Mmrliu-gooooood/digital_pen/实施方案.md

# ESP32-S3 + OV5640 黑白 Anoto 点阵笔实施方案

> **For agentic workers:** REQUIRED SUB-SKILL: Use `superpowers:subagent-driven-development` (recommended) or `superpowers:executing-plans` to implement this plan task-by-task. Steps use checkbox (`- [ ]`) syntax for tracking.

**Goal:** 使用 ESP32-S3 N16R8 和 OV5640 采集白底黑点 Anoto 纸面图像，先在 PC 端通过 Python/OpenCV 恢复 Anoto 坐标、笔尖轨迹和简单字符结果，算法稳定后再逐步移植到 ESP32-S3。

**Architecture:** Task 4～10 属于开发与算法验证阶段：ESP32-S3 采集无损灰度帧，通过 Wi-Fi STA + HTTP 交给同一局域网内的 PC；STA 连接失败时自动回退 SoftAP，USB 作为实验室诊断和可选原始帧通道。PC 完成视觉、Anoto 解码、轨迹与识别。Task 11 开始进入笔形产品架构：视觉坐标前端移植到 ESP32-S3，终端不再接收原始帧，而通过 BLE 自定义 GATT 接收坐标和笔状态。

**Tech Stack:** ESP-IDF、`espressif/esp32-camera ^2.1.7`、ESP32-S3 N16R8、OV5640、C/C++、Python 3.11+、OpenCV、NumPy、pytest、py-microdots、Rust AnotoPdfGenerator/AnotoDotReader（外部参考工具）。

**Spec:** `D:\ESP32_project\digital_pen\实施方案.md`（本文第 1～7 节同时作为已确认的设计规格）。

## Global Constraints

- 最终纸张必须是白底黑点，不依赖彩色打印或颜色分类。
- 原型采用“PC 先验证算法，再移植 ESP32-S3”；手写识别初期保留在 PC。
- Task 4～10 仅使用 Wi-Fi/USB 传输原始灰度帧；Task 11 起使用 BLE 传输坐标。BLE 不承担原始 QVGA 帧传输。
- Anoto 图案由 `D:\ESP32_project\AnotoPdfGenerator\AnotoPdfGenerator-main` 生成，解码协议与该项目及 py-microdots 保持一致。
- `D:\ESP32_project\AnotoDotReader\AnotoDotReader-main` 只作为网格处理和解码参考；其当前颜色方向分类不能直接用于黑白点阵。
- 每张点阵纸必须保留 PDF、方向矩阵、section、网格间距、点半径和方向偏移量，保证算法结果可与生成真值比较。
- `app_main` 只做初始化和任务编排，不承载图像算法。
- PC 端视觉模块只输出方向矩阵；Anoto 模块只处理方向矩阵和坐标协议，不依赖 OpenCV。
- 第一版落笔判断允许通过新墨迹延迟确认；压力传感器、微动开关等外设不进入第一版范围。
- 新墨迹确认采用 100～200 ms 坐标环形缓冲，确认后回溯形成笔画起点。
- 当前 `sdkconfig` 未开启 PSRAM，进入连续采集前必须为 N16R8 开启并验证 8 MB PSRAM。
- 当前开发板未给出确切相机 GPIO 映射；实现时必须从实际原理图和接线记录生成板级引脚文件，不得套用其他 ESP32-S3 Camera 板的默认引脚。
- 不直接复制 AnotoPdfGenerator、AnotoDotReader 或 py-microdots 源码到本工程；通过适配器或包依赖连接，避免维护分叉版本。

---

## 1. 当前状态与范围

### 1.1 当前工程状态

工程位置：`D:\ESP32_project\digital_pen\digital_pen_ov5640`

- `main/main.c` 只有空的 `app_main()`。
- `main/idf_component.yml` 已声明 `espressif/esp32-camera: ^2.1.7`。
- `sdkconfig` 已启用 OV5640 支持。
- `sdkconfig` 尚未启用 PSRAM。
- 尚无相机 GPIO、像素格式、分辨率、采集、传输或 PC 客户端实现。

### 1.2 第一版完成定义

第一版完整闭环定义为：

```text
黑白 Anoto 纸
  → OV5640 灰度帧
  → PC 黑点/网格/方向识别
  → Anoto 坐标
  → 笔尖纸面坐标
  → 新墨迹确认落笔
  → 笔画序列
  → 小规模字符集识别结果
```

第一版不要求：

- 全部常用汉字的高准确率识别；
- 自然书写速度下的商业级跟踪；
- 所有视觉算法和识别模型都运行在 ESP32-S3；
- 在已有墨迹上重复书写时仍能只凭图像准确判断落笔；
- 更换任意镜头、纸张或打印机后无需重新标定。

---

## 2. 总体架构与数据接口

```text
AnotoPdfGenerator
  ├─ 黑白点阵 PDF
  ├─ 方向矩阵 JSON
  └─ 图案参数清单
          ↓
ESP32-S3 + OV5640
  ├─ Task 4～10：灰度帧、帧号、时间戳、曝光信息
  │       └─ Wi-Fi STA + HTTP（主通道，失败回退 SoftAP）/ USB（诊断、可选）→ PC
  └─ Task 11 起：板端视觉与 Anoto 坐标解码
          └─ BLE 自定义 GATT → 坐标、置信度、落笔状态 → 终端
          ↓（开发阶段 PC 视觉流水线）
Python/OpenCV
  ├─ 镜头校正
  ├─ 黑点质心
  ├─ 网格与透视
  └─ 上下左右方向矩阵
          ↓
Anoto Codec
  ├─ 多个 6×6 窗口解码
  └─ 一致性投票与置信度
          ↓
笔尖坐标
  ├─ 相机像素到纸面坐标
  └─ 轨迹滤波
          ↓
墨迹与笔画
  ├─ 已知点阵背景扣除
  ├─ 新墨迹延迟确认
  └─ 落笔/抬笔分段
          ↓
PC 手写识别
```

### 2.1 PC 端核心类型

在 `pc/src/digital_pen/types.py` 中统一定义以下类型，后续模块不得自行创建同义结构：

```python
from dataclasses import dataclass
from enum import IntEnum
import numpy as np

class DotDirection(IntEnum):
    UP = 0
    LEFT = 1
    RIGHT = 2
    DOWN = 3

@dataclass(frozen=True)
class CameraFrame:
    frame_id: int
    timestamp_us: int
    image: np.ndarray          # uint8, shape=(height, width)
    exposure: int | None

@dataclass(frozen=True)
class DotObservation:
    center_px: tuple[float, float]
    area_px: float
    circularity: float

@dataclass(frozen=True)
class LatticeModel:
    grid_to_image: np.ndarray  # float64, shape=(3, 3)
    spacing_px: float
    rms_error_px: float

@dataclass(frozen=True)
class DirectionObservation:
    row: int
    col: int
    direction: DotDirection
    residual_grid: tuple[float, float]
    confidence: float

@dataclass(frozen=True)
class DecodedPose:
    timestamp_us: int
    page_id: str
    x_grid: float
    y_grid: float
    rotation_quadrants: int
    confidence: float

@dataclass(frozen=True)
class PenPoint:
    timestamp_us: int
    x_mm: float
    y_mm: float
    confidence: float
    pen_down: bool
```

### 2.2 Task 4～10：开发阶段原始帧接口

开发固件默认以 STA 模式连接已配置的 2.4 GHz Wi-Fi，PC 保持连接同一局域网，并使用串口日志输出的 DHCP 地址访问设备。15 秒内未取得 IP 时，设备自动启动 SoftAP，回退地址为 `http://192.168.4.1`。原型统一使用两个 HTTP 端点：

- `GET /status`：返回 JSON，至少包含传感器型号、分辨率、像素格式、PSRAM 大小和帧计数。
- `GET /capture.pgm`：返回一帧二进制 PGM（P5）灰度图，并用 HTTP Header 返回 `X-Frame-Id`、`X-Timestamp-Us`、`X-Exposure`。

PGM 可避免 JPEG 压缩破坏微小黑点质心。USB 保留为实验室诊断和后续可选原始帧通道，不作为 Task 4 的 Exit Gate；连续实时性能不足时，再在 Wi-Fi 或 USB 上增加长连接二进制流。

### 2.3 Task 11 起：最终产品 BLE 坐标接口

ESP32-S3 作为 BLE Peripheral 暴露自定义 Digital Pen Service，终端订阅坐标通知。通知负载只携带协议版本、序号、时间、页面/区域标识、`x/y` 坐标、置信度和 `pen_down`，不传原始图像。单包优先控制在协商后的 ATT MTU 内；断线后继续递增序号，终端据此检测丢包。调试固件可以保留按需抓取原始帧的 Wi-Fi/USB 能力，但默认关闭，不属于产品实时数据通道。

---

## 3. 建议源码目录

```text
digital_pen_ov5640/
├── CMakeLists.txt
├── sdkconfig
├── sdkconfig.defaults
├── main/
│   ├── CMakeLists.txt
│   ├── app_main.c
│   └── app_config.h
├── components/
│   ├── camera_capture/
│   │   ├── CMakeLists.txt
│   │   ├── include/camera_capture.h
│   │   ├── camera_capture.c
│   │   └── board_camera_pins.h
│   ├── frame_transport/
│   │   ├── CMakeLists.txt
│   │   ├── include/frame_transport.h
│   │   ├── frame_transport.c
│   │   └── transport_http.c
│   ├── network_manager/
│   │   ├── CMakeLists.txt
│   │   ├── include/network_manager.h
│   │   └── network_manager.c
│   ├── device_protocol/
│   │   ├── CMakeLists.txt
│   │   ├── include/device_protocol.h
│   │   └── device_protocol.c
│   ├── anoto_embedded/
│   │   ├── CMakeLists.txt
│   │   ├── include/anoto_embedded.h
│   │   ├── dot_detector.c
│   │   ├── grid_fitter.c
│   │   ├── direction_classifier.c
│   │   └── anoto_decoder.c
│   ├── pen_pose/
│   │   ├── CMakeLists.txt
│   │   ├── include/pen_pose.h
│   │   └── pen_pose.c
│   ├── pen_state/
│   │   ├── CMakeLists.txt
│   │   ├── include/pen_state.h
│   │   └── pen_state.c
│   └── ble_transport/
│       ├── CMakeLists.txt
│       ├── include/ble_transport.h
│       └── ble_transport.c
├── pc/
│   ├── pyproject.toml
│   ├── README.md
│   ├── src/digital_pen/
│   │   ├── __init__.py
│   │   ├── types.py
│   │   ├── camera/
│   │   │   ├── esp32_client.py
│   │   │   └── frame_recorder.py
│   │   ├── calibration/
│   │   │   ├── camera_calibration.py
│   │   │   ├── distortion.py
│   │   │   └── nib_calibration.py
│   │   ├── vision/
│   │   │   ├── preprocessing.py
│   │   │   ├── dot_detector.py
│   │   │   ├── grid_fitter.py
│   │   │   ├── perspective.py
│   │   │   └── direction_classifier.py
│   │   ├── anoto/
│   │   │   ├── matrix_builder.py
│   │   │   ├── codec_adapter.py
│   │   │   └── window_consensus.py
│   │   ├── pose/
│   │   │   ├── page_pose.py
│   │   │   ├── nib_mapper.py
│   │   │   └── position_filter.py
│   │   ├── ink/
│   │   │   ├── dot_background.py
│   │   │   ├── ink_detector.py
│   │   │   └── pen_state_estimator.py
│   │   ├── strokes/
│   │   │   ├── point_buffer.py
│   │   │   ├── stroke_builder.py
│   │   │   └── stroke_normalizer.py
│   │   ├── recognition/
│   │   │   ├── recognizer.py
│   │   │   └── onnx_recognizer.py
│   │   └── pipeline/
│   │       ├── offline_pipeline.py
│   │       └── live_pipeline.py
│   ├── apps/
│   │   ├── capture_frame.py
│   │   ├── calibrate_camera.py
│   │   ├── inspect_dots.py
│   │   ├── decode_image.py
│   │   ├── live_coordinates.py
│   │   └── live_handwriting.py
│   └── configs/
│       ├── camera.yaml
│       ├── dot_detection.yaml
│       ├── pattern.yaml
│       └── nib_calibration.yaml
├── tools/patterns/
│   ├── generate_pattern.py
│   ├── verify_codec.py
│   └── generator_adapter.py
└── docs/
    ├── camera-pinout.md
    ├── pattern-parameters.md
    └── calibration.md
```

`anoto_embedded`、`pen_pose`、`pen_state` 和 `ble_transport` 在对应移植阶段再创建；早期不放无实现的空壳组件。

---

## 4. 点阵与光学分级

所有等级都使用黑色点，不增加彩色打印成本。

| 等级 | 网格间距 | 方向偏移 | 点半径 | 用途 |
|---|---:|---:|---:|---|
| A：算法调试 | 3.53 mm（10 pt） | 1.06 mm（3 pt） | 0.35 mm（1 pt） | 验证协议、网格和方向分类 |
| B：光学过渡 | 1.00 mm | 0.167 mm | 0.10 mm | 验证真实黑点、透视和运动 |
| C：目标微点 | 0.30 mm | 0.05 mm | 0.05 mm | 接近标准 Anoto 尺寸 |

目标微点方向偏移只有约 0.05 mm。为了在图像中形成至少 2 像素偏移，成像比例至少需要约 40 px/mm；VGA 宽度 640 像素时，横向视场应不大于约 16 mm。达到该条件通常需要合适的近摄镜头、稳定工作距离和均匀照明。

每一级只有在静态坐标解码成功率达到本方案门槛后才缩小尺寸。尺寸分级是降低光学风险，不改变 Anoto 编码协议。

---

## 5. 分阶段实施任务

### Task 1：建立黑白点阵生成与协议真值

**Files:**

- Create: `tools/patterns/generator_adapter.py`
- Create: `tools/patterns/verify_codec.py`
- Create: `pc/configs/pattern.yaml`
- Create: `docs/pattern-parameters.md`

**Interfaces:**

- Consumes: AnotoPdfGenerator 输出的 PDF 和方向矩阵 JSON。
- Produces: `PatternManifest`，字段固定为 `page_id`、`section_u`、`section_v`、`rows`、`cols`、`grid_spacing_mm`、`dot_radius_mm`、`offset_mm`、`matrix_json`、`pdf_path`。

- [ ] **Step 1: 固化三级黑白点阵参数**

在 `pc/configs/pattern.yaml` 中写入 A/B/C 三个 profile，所有方向颜色统一为 `#000000`，尺寸使用第 4 节数值。

- [ ] **Step 2: 编写生成器适配器**

`generator_adapter.py` 负责读取 profile、调用外部 Generator，并为 PDF 和矩阵写入同名 manifest。接口固定为：

```python
def generate_pattern(profile_name: str, rows: int, cols: int,
                     section_u: int, section_v: int,
                     output_dir: str) -> str:
    """返回 manifest JSON 的绝对路径。"""
```

- [ ] **Step 3: 编写协议一致性验证**

`verify_codec.py` 从方向矩阵随机提取 1000 个 `6×6` 窗口，使用 py-microdots 解码，并与窗口行列和 section 真值比较。

Run:

```powershell
python tools/patterns/verify_codec.py --manifest <manifest.json> --samples 1000
```

Expected: 输出 `1000/1000 windows decoded correctly`，进程退出码为 0。

- [ ] **Step 4: 记录打印参数**

`docs/pattern-parameters.md` 必须记录打印机 DPI、实际大小 100%、纸张、profile、打印日期，并要求用卡尺或扫描标尺核对实际网格间距。

- [ ] **Step 5: 建议提交点**

```powershell
git add tools/patterns pc/configs/pattern.yaml docs/pattern-parameters.md
git commit -m "feat: add monochrome Anoto pattern contract"
```

**Exit Gate:** 1000 个随机窗口全部正确；Generator 和 py-microdots 的方向映射保持 `↑=(0,0)、←=(1,0)、→=(0,1)、↓=(1,1)`。

### Task 2：建立 PC Python 包和统一数据类型

**Files:**

- Create: `pc/pyproject.toml`
- Create: `pc/src/digital_pen/__init__.py`
- Create: `pc/src/digital_pen/types.py`
- Create: `pc/tests/test_types.py`

**Interfaces:**

- Consumes: Python 3.11+、NumPy、OpenCV、py-microdots。
- Produces: 第 2.1 节定义的七个公共类型。

- [ ] **Step 1: 创建 Python 包配置**

`pyproject.toml` 声明 `numpy`、`opencv-python`、`requests`、`PyYAML`、`microdots`，开发依赖声明 `pytest` 和 `ruff`。

- [ ] **Step 2: 先写类型约束测试**

```python
def test_camera_frame_requires_grayscale_uint8():
    image = np.zeros((240, 320), dtype=np.uint8)
    frame = CameraFrame(1, 1000, image, None)
    assert frame.image.shape == (240, 320)
    assert frame.image.dtype == np.uint8
```

- [ ] **Step 3: 实现统一类型**

按第 2.1 节实现，模块边界只传这些结构或 NumPy 方向矩阵。

- [ ] **Step 4: 验证包安装和测试**

```powershell
python -m pip install -e "pc[dev]"
python -m pytest pc/tests/test_types.py -v
python -m ruff check pc
```

Expected: pytest 全部通过，ruff 退出码为 0。

- [ ] **Step 5: 建议提交点**

```powershell
git add pc
git commit -m "build: initialize PC vision package"
```

**Exit Gate:** `digital_pen` 可编辑安装成功，公共类型测试通过。

### Task 3：点亮 OV5640 并稳定输出灰度帧

**Files:**

- Modify: `sdkconfig.defaults`
- Modify: `main/CMakeLists.txt`
- Replace: `main/main.c` with `main/app_main.c`
- Create: `main/app_config.h`
- Create: `components/camera_capture/CMakeLists.txt`
- Create: `components/camera_capture/include/camera_capture.h`
- Create: `components/camera_capture/camera_capture.c`
- Create: `components/camera_capture/board_camera_pins.h`
- Create: `docs/camera-pinout.md`

**Interfaces:**

- Produces: `esp_err_t camera_capture_init(void)`、`camera_fb_t *camera_capture_get(void)`、`void camera_capture_return(camera_fb_t *fb)`。
- Consumes: 根据实际原理图填写的 GPIO 宏和 `esp_camera` API。

- [ ] **Step 1: 核对实际引脚**

在 `docs/camera-pinout.md` 逐项记录 `PWDN`、`RESET`、`XCLK`、`SIOD`、`SIOC`、`Y2..Y9`、`VSYNC`、`HREF`、`PCLK` 的 GPIO。每一项必须来自板卡原理图或实际接线，不从示例板型推测。

- [ ] **Step 2: 启用 N16R8 PSRAM**

通过 `idf.py menuconfig` 选择 ESP32-S3 Octal PSRAM 并写入 `sdkconfig.defaults`；启动日志必须打印检测到约 8 MB PSRAM。

- [ ] **Step 3: 编写最小相机组件**

初始配置固定为：

```c
.pixel_format = PIXFORMAT_GRAYSCALE,
.frame_size = FRAMESIZE_QVGA,
.xclk_freq_hz = 20000000,
.fb_count = 2,
.grab_mode = CAMERA_GRAB_LATEST,
```

初始化后读取传感器 PID，确认返回 OV5640；失败时不启动传输服务。

- [ ] **Step 4: 编写相机烟雾测试模式**

`app_main` 连续获取并归还 1000 帧，每 100 帧打印帧号、长度、尺寸和堆内存。

- [ ] **Step 5: 构建、烧录并读取日志**

```powershell
idf.py build
idf.py -p <实际串口> flash monitor
```

Expected: OV5640 识别成功、PSRAM 约 8 MB、1000 帧完成、无 camera timeout、无重启。

- [ ] **Step 6: 建议提交点**

```powershell
git add sdkconfig.defaults main components/camera_capture docs/camera-pinout.md
git commit -m "feat: add stable OV5640 grayscale capture"
```

**Exit Gate:** 连续 1000 帧稳定采集；帧缓冲归还后可用堆不持续下降。

### Task 4：把原始灰度帧可靠发送到 PC

**Files:**

- Create: `components/device_protocol/CMakeLists.txt`
- Create: `components/device_protocol/include/device_protocol.h`
- Create: `components/device_protocol/device_protocol.c`
- Create: `components/frame_transport/CMakeLists.txt`
- Create: `components/frame_transport/include/frame_transport.h`
- Create: `components/frame_transport/frame_transport.c`
- Create: `components/frame_transport/transport_http.c`
- Create: `components/network_manager/CMakeLists.txt`
- Create: `components/network_manager/include/network_manager.h`
- Create: `components/network_manager/network_manager.c`
- Modify: `main/app_main.c`
- Create: `pc/src/digital_pen/camera/esp32_client.py`
- Create: `pc/apps/capture_frame.py`
- Create: `pc/tests/camera/test_pgm.py`

**Interfaces:**

- Firmware first connects to the configured 2.4 GHz Wi-Fi in STA mode, falls back to a development SoftAP after timeout, and produces: `GET /status` and `GET /capture.pgm`。
- PC produces: `Esp32CameraClient.capture() -> CameraFrame`。

- [ ] **Step 1: 先写 PGM 解析测试**

使用内存中的 `P5\n4 2\n255\n` 加 8 字节像素，验证返回 `shape=(2,4)`、`dtype=uint8` 且像素逐字节一致。

- [x] **Step 2: 启动 STA 优先、SoftAP 回退的开发网络**

设备优先连接 Kconfig/本地 `sdkconfig` 配置的 2.4 GHz Wi-Fi，15 秒内没有获得 DHCP 地址时切换为独立热点。回退 SSID 使用 `digital-pen-<MAC 后六位>`，服务地址为 `192.168.4.1`。实际 Wi-Fi 密码仅写入 Git 忽略的本地 `sdkconfig`，串口日志只打印 SSID、模式、IP 和 HTTP 地址，不打印密码。

- [ ] **Step 3: 实现固件 PGM 响应**

发送合法 P5 Header 后直接发送灰度帧缓冲，不复制整帧；HTTP 完成后立即调用 `esp_camera_fb_return()`。

- [ ] **Step 4: 实现 PC 客户端**

```python
class Esp32CameraClient:
    def __init__(self, base_url: str, timeout_s: float = 2.0): ...
    def status(self) -> dict: ...
    def capture(self) -> CameraFrame: ...
```

- [ ] **Step 5: 保存真实样图**

```powershell
python pc/apps/capture_frame.py --url http://<串口日志中的设备IP> --output frame.pgm --count 100
```

Expected: 保存 100 张尺寸一致的灰度图，帧号严格递增。

- [ ] **Step 6: 验证点阵成像比例**

用 profile A 点阵固定拍摄，测量网格间距和方向偏移。网格至少 12 px、偏移至少 2 px；若不满足，调整镜头、距离或图案等级后重新测量。

- [ ] **Step 7: 建议提交点**

```powershell
git add components/device_protocol components/frame_transport components/network_manager main pc/src/digital_pen/camera pc/apps/capture_frame.py pc/tests/camera
git commit -m "feat: stream raw grayscale frames to PC"
```

**Exit Gate:** PC 与设备接入同一 Wi-Fi 后可重复读取 100 帧；错误凭据时设备可自动回退 SoftAP；帧号严格递增；图像未经缩放和 JPEG 压缩；点阵达到最小像素尺度。USB 不作为本任务验收前置条件。

### Task 5：离线检测黑点质心

**Files:**

- Create: `pc/src/digital_pen/vision/preprocessing.py`
- Create: `pc/src/digital_pen/vision/dot_detector.py`
- Create: `pc/apps/inspect_dots.py`
- Create: `pc/tests/vision/test_dot_detector.py`

**Interfaces:**

- Consumes: `CameraFrame.image`。
- Produces: `list[DotObservation]` 和二值前景图。

- [ ] **Step 1: 写合成圆点检测测试**

生成白底黑圆图，加入亮度梯度和轻微高斯模糊，断言检测数正确且质心误差小于 0.25 px。

- [ ] **Step 2: 实现预处理**

顺序固定为畸变校正、可选局部对比度增强、Otsu/自适应阈值、形态学去噪。每一步可以通过配置关闭，并能输出中间图。

- [ ] **Step 3: 实现连通域筛选与亚像素质心**

筛选面积、长宽比和圆度；质心使用灰度反权重：像素越黑权重越高。接口固定为：

```python
def detect_dots(gray: np.ndarray, config: DotDetectorConfig
                ) -> tuple[list[DotObservation], np.ndarray]:
    ...
```

- [ ] **Step 4: 生成可视化标注图**

`inspect_dots.py` 在原图上标记质心、面积异常和漏检区域，禁止仅输出一个总数。

- [ ] **Step 5: 验证四类图像**

依次运行 Generator PNG、打印扫描图、手机图和 OV5640 静态图。清晰 OV5640 图的点检出率至少 98%，明显非点阵连通域不得进入结果。

- [ ] **Step 6: 建议提交点**

```powershell
git add pc/src/digital_pen/vision pc/apps/inspect_dots.py pc/tests/vision
git commit -m "feat: detect monochrome dot centroids"
```

**Exit Gate:** 合成质心误差小于 0.25 px；真实清晰图点检出率达到 98%。

### Task 6：拟合网格、透视并分类四方向

**Files:**

- Create: `pc/src/digital_pen/vision/grid_fitter.py`
- Create: `pc/src/digital_pen/vision/perspective.py`
- Create: `pc/src/digital_pen/vision/direction_classifier.py`
- Create: `pc/src/digital_pen/anoto/matrix_builder.py`
- Create: `pc/tests/vision/test_grid_fitter.py`
- Create: `pc/tests/vision/test_direction_classifier.py`

**Interfaces:**

- Consumes: `list[DotObservation]`。
- Produces: `LatticeModel`、`list[DirectionObservation]`、`np.ndarray` 方向矩阵。

- [ ] **Step 1: 写旋转与透视合成测试**

从已知方向矩阵生成网格点，施加旋转、缩放、透视、0.2 px 噪声和少量漏点；断言恢复的网格索引一致，RMS 小于 0.5 px。

- [ ] **Step 2: 实现初始网格基向量估计**

用邻近点差向量的方向直方图得到两条近似正交基向量，再用 RANSAC 去除墨迹和噪声点。

- [ ] **Step 3: 实现网格索引分配与单应性优化**

将每个点分配到整数网格行列，使用鲁棒最小二乘优化 `grid_to_image`；输出 RMS 和内点比例。

- [ ] **Step 4: 实现方向分类**

先把检测质心映射回归一化网格坐标，再计算相对整数网格中心的残差：

```python
def classify_direction(dx: float, dy: float,
                       min_offset: float = 0.08) -> tuple[DotDirection, float]:
    axis = max(abs(dx), abs(dy))
    if axis < min_offset:
        raise ValueError("direction offset is below confidence threshold")
    if abs(dx) > abs(dy):
        return (DotDirection.RIGHT if dx > 0 else DotDirection.LEFT,
                abs(dx) / (abs(dx) + abs(dy) + 1e-9))
    return (DotDirection.DOWN if dy > 0 else DotDirection.UP,
            abs(dy) / (abs(dx) + abs(dy) + 1e-9))
```

- [ ] **Step 5: 组装方向矩阵并与 Generator 真值比较**

只有置信度达到配置门槛的点进入矩阵；在 Generator PNG 上方向正确率必须为 100%，打印扫描图和清晰 OV5640 图达到至少 99%。

- [ ] **Step 6: 建议提交点**

```powershell
git add pc/src/digital_pen/vision pc/src/digital_pen/anoto/matrix_builder.py pc/tests/vision
git commit -m "feat: recover lattice and monochrome dot directions"
```

**Exit Gate:** 真实清晰图方向正确率至少 99%；网格拟合 RMS 小于 0.5 px。

### Task 7：复用 Anoto Codec 并进行多窗口一致性解码

**Files:**

- Create: `pc/src/digital_pen/anoto/codec_adapter.py`
- Create: `pc/src/digital_pen/anoto/window_consensus.py`
- Create: `pc/apps/decode_image.py`
- Create: `pc/tests/anoto/test_codec_adapter.py`
- Create: `pc/tests/anoto/test_window_consensus.py`

**Interfaces:**

- Consumes: 包含缺失值和置信度的方向矩阵。
- Produces: `DecodedPose`。

- [ ] **Step 1: 写方向映射回归测试**

验证 `UP=(0,0)、LEFT=(1,0)、RIGHT=(0,1)、DOWN=(1,1)` 与 Generator 和现有 Rust Reader 完全一致。

- [ ] **Step 2: 实现 codec 适配器**

```python
class AnotoCodecAdapter:
    def decode_window(self, directions: np.ndarray,
                      section: tuple[int, int]) -> tuple[int, int]: ...
```

适配器内部使用 py-microdots；OpenCV 类型和图像不得进入该模块。

- [ ] **Step 3: 实现滑动窗口和一致性评分**

枚举全部有效 `6×6` 窗口；将每个窗口解码坐标换算到同一参考原点；按支持窗口数、单点方向置信度和相邻坐标连续性计算最终置信度。

- [ ] **Step 4: 编写离线端到端命令**

```powershell
python pc/apps/decode_image.py --image <ov5640-frame.pgm> --pattern pc/configs/pattern.yaml --annotated decoded.png
```

Expected: 输出 page、网格坐标、有效窗口数、置信度和标注图。

- [ ] **Step 5: 验证静态成功率**

对同一已知位置拍摄至少 100 张清晰帧；正确坐标比例至少 95%，错误结果不得被标记为高置信度。

- [ ] **Step 6: 建议提交点**

```powershell
git add pc/src/digital_pen/anoto pc/apps/decode_image.py pc/tests/anoto
git commit -m "feat: decode Anoto coordinates with window consensus"
```

**Exit Gate:** 静态清晰帧坐标正确率至少 95%，静止坐标无大幅随机跳变。

### Task 8：实时坐标、笔尖标定和轨迹重建

**Files:**

- Create: `pc/src/digital_pen/calibration/camera_calibration.py`
- Create: `pc/src/digital_pen/calibration/distortion.py`
- Create: `pc/src/digital_pen/calibration/nib_calibration.py`
- Create: `pc/src/digital_pen/pose/page_pose.py`
- Create: `pc/src/digital_pen/pose/nib_mapper.py`
- Create: `pc/src/digital_pen/pose/position_filter.py`
- Create: `pc/src/digital_pen/pipeline/live_pipeline.py`
- Create: `pc/apps/calibrate_camera.py`
- Create: `pc/apps/live_coordinates.py`
- Create: `pc/tests/pose/test_nib_mapper.py`

**Interfaces:**

- Consumes: `CameraFrame`、`LatticeModel`、`DecodedPose`、笔尖固定像素坐标。
- Produces: `PenPoint` 流。

- [ ] **Step 1: 标定镜头内参和畸变**

使用打印标定板采集多个角度，保存相机矩阵和畸变参数到 `pc/configs/camera.yaml`；重投影 RMS 目标小于 0.5 px。

- [ ] **Step 2: 标定笔尖像素**

让笔尖依次对准多个已知纸面点，通过当前网格单应性反求固定笔尖像素；用鲁棒中位数写入 `pc/configs/nib_calibration.yaml`。

- [ ] **Step 3: 实现笔尖映射**

```python
def map_nib_to_page(nib_pixel: tuple[float, float],
                    lattice: LatticeModel,
                    decoded_pose: DecodedPose,
                    grid_spacing_mm: float) -> tuple[float, float]:
    ...
```

- [ ] **Step 4: 实现位置滤波**

滤波只平滑可信连续点；坐标跳变超过合理速度或置信度不足时输出无效点，禁止把预测值伪装成测量值。

- [ ] **Step 5: 运行实时坐标程序**

```powershell
python pc/apps/live_coordinates.py --url http://<设备IP> --config pc/configs
```

Expected: 缓慢移动时每秒至少 20 个有效坐标，固定位置抖动小于 1 mm。

- [ ] **Step 6: 验证基本图形**

使用人工键盘开关标记落笔，绘制横线、竖线、圆和十字；PC 重绘形状方向正确、无跨页跳点，初期笔尖位置误差不超过 1 mm。

- [ ] **Step 7: 建议提交点**

```powershell
git add pc/src/digital_pen/calibration pc/src/digital_pen/pose pc/src/digital_pen/pipeline/live_pipeline.py pc/apps/calibrate_camera.py pc/apps/live_coordinates.py pc/tests/pose pc/configs
git commit -m "feat: map Anoto pose to calibrated nib trajectory"
```

**Exit Gate:** 慢速移动达到 20～30 个有效位置/秒；基本图形能够可靠重建。

### Task 9：通过新墨迹延迟确认落笔和抬笔

**Files:**

- Create: `pc/src/digital_pen/ink/dot_background.py`
- Create: `pc/src/digital_pen/ink/ink_detector.py`
- Create: `pc/src/digital_pen/ink/pen_state_estimator.py`
- Create: `pc/src/digital_pen/strokes/point_buffer.py`
- Create: `pc/src/digital_pen/strokes/stroke_builder.py`
- Create: `pc/tests/ink/test_pen_state_estimator.py`
- Create: `pc/tests/strokes/test_point_buffer.py`

**Interfaces:**

- Consumes: 校正后的灰度帧、页面单应性、已知点阵 manifest、`PenPoint` 坐标流。
- Produces: 带 `pen_down` 的 `PenPoint` 和独立笔画列表。

- [ ] **Step 1: 写延迟确认状态机测试**

构造坐标序列：悬空移动、150 ms 后出现新墨迹、持续书写、墨迹停止。断言出现墨迹时回溯确认 150 ms 缓冲点，停止超过阈值后关闭笔画。

- [ ] **Step 2: 生成点阵背景遮罩**

根据 manifest 和当前单应性预测图像中的微点位置；遮罩半径略大于打印点，防止静态点阵进入墨迹检测。

- [ ] **Step 3: 检测新墨迹**

将连续帧变换到统一纸面局部坐标，扣除点阵遮罩；仅保留宽度和连续性明显大于微点、且位于笔尖后方 ROI 的新黑色结构。

- [ ] **Step 4: 实现坐标环形缓冲**

```python
class PointBuffer:
    def __init__(self, duration_ms: int = 200): ...
    def append(self, point: PenPoint) -> None: ...
    def confirm_since(self, timestamp_us: int) -> list[PenPoint]: ...
```

- [ ] **Step 5: 实现笔画状态机**

新墨迹连续确认后进入 DOWN，并回溯缓冲点；连续无新墨迹达到配置时间后进入 UP。所有状态转换带时间迟滞，避免单帧噪声分裂笔画。

- [ ] **Step 6: 验证简单笔画**

悬空移动不得生成笔画；书写“一、十、口、日”时笔画起点不明显缺失，抬笔后的两笔不得被错误连接。

- [ ] **Step 7: 建议提交点**

```powershell
git add pc/src/digital_pen/ink pc/src/digital_pen/strokes pc/tests/ink pc/tests/strokes
git commit -m "feat: infer pen state from newly written ink"
```

**Exit Gate:** 悬空移动无笔画；简单字符的落笔/抬笔分段可重复。

### Task 10：笔画标准化和小规模字符识别

**Files:**

- Create: `pc/src/digital_pen/strokes/stroke_normalizer.py`
- Create: `pc/src/digital_pen/recognition/recognizer.py`
- Create: `pc/src/digital_pen/recognition/onnx_recognizer.py`
- Create: `pc/apps/live_handwriting.py`
- Create: `pc/tests/strokes/test_stroke_normalizer.py`
- Create: `pc/tests/recognition/test_recognizer_contract.py`

**Interfaces:**

- Consumes: `list[list[PenPoint]]`。
- Produces: `list[tuple[str, float]]`，按置信度从高到低排列候选字符。

- [ ] **Step 1: 实现笔画标准化**

依次完成去除重复点、轻度平滑、按弧长重采样、保持纵横比归一化；必须保留笔画数量和顺序。

- [ ] **Step 2: 定义识别器接口**

```python
class StrokeRecognizer(Protocol):
    def recognize(self, strokes: list[list[PenPoint]],
                  top_k: int = 5) -> list[tuple[str, float]]: ...
```

- [ ] **Step 3: 接入 PC 端 ONNX 在线笔迹模型**

第一组类别固定为数字 `0～9`；数字闭环稳定后再替换或扩展为选定的简单汉字集合。模型输入转换集中在 `onnx_recognizer.py`，其余模块不依赖 ONNX 张量布局。

- [ ] **Step 4: 集成完整实时程序**

```powershell
python pc/apps/live_handwriting.py --url http://<设备IP> --config pc/configs --model <模型路径>
```

界面同时显示原始帧、点阵方向、当前坐标、重建笔画和 Top-5 候选，便于区分视觉错误、轨迹错误和模型错误。

- [ ] **Step 5: 验证闭环**

同一书写者每个数字至少书写 20 次；先确保 PC 重建轨迹肉眼正确，再统计识别结果。识别失败但轨迹正确时只调整识别模块，不回改点阵视觉参数。

- [ ] **Step 6: 建议提交点**

```powershell
git add pc/src/digital_pen/strokes/stroke_normalizer.py pc/src/digital_pen/recognition pc/apps/live_handwriting.py pc/tests/strokes pc/tests/recognition
git commit -m "feat: recognize characters from reconstructed strokes"
```

**Exit Gate:** 完成“写数字 → 重建笔画 → 输出候选结果”的端到端演示；简单汉字作为下一组类别扩展。

### Task 11：将稳定的坐标前端逐步移植到 ESP32-S3

**Files:**

- Create: `components/anoto_embedded/CMakeLists.txt`
- Create: `components/anoto_embedded/include/anoto_embedded.h`
- Create: `components/anoto_embedded/dot_detector.c`
- Create: `components/anoto_embedded/grid_fitter.c`
- Create: `components/anoto_embedded/direction_classifier.c`
- Create: `components/anoto_embedded/anoto_decoder.c`
- Create: `components/pen_pose/CMakeLists.txt`
- Create: `components/pen_pose/include/pen_pose.h`
- Create: `components/pen_pose/pen_pose.c`
- Create: `components/ble_transport/CMakeLists.txt`
- Create: `components/ble_transport/include/ble_transport.h`
- Create: `components/ble_transport/ble_transport.c`
- Create: `pc/src/digital_pen/transport/ble_client.py`
- Modify: `main/app_main.c`

**Interfaces:**

- Consumes: OV5640 灰度 ROI、PC 固化的参数和测试向量。
- Produces: `timestamp_us, x_mm, y_mm, confidence, pen_state`，并通过 BLE 自定义 GATT 通知终端；识别仍可由 PC/终端执行。

- [ ] **Step 1: 导出 PC 参考向量**

对固定真实帧保存黑点质心、网格矩阵、方向矩阵和最终坐标。ESP32 每移植一个子模块，就逐项与 PC 参考输出比较。

- [ ] **Step 2: 移植 ROI 与质心检测**

只处理笔尖附近 ROI，使用预分配缓冲和整数/定点运算；先达到质心与 PC 结果误差小于 0.5 px。

- [ ] **Step 3: 移植网格拟合和方向分类**

固定最大点数和迭代次数，避免动态内存；方向矩阵必须与 PC 对同一输入完全一致。

- [ ] **Step 4: 移植 6×6 解码和多窗口投票**

使用编译期常量存储序列；先对 Task 1 的 1000 个窗口运行 Unity 单元测试，再连接实时视觉结果。

- [ ] **Step 5: 移植笔尖坐标换算**

使用 PC 标定参数；ESP32 输出坐标与 PC 对同帧结果误差小于 0.3 mm。

- [ ] **Step 6: 实现 BLE 坐标协议与 GATT 服务**

定义带版本号和序号的紧凑二进制坐标包，ESP32-S3 作为 Peripheral，终端订阅 Notification。验证坐标、置信度和落笔状态可解析，断连重连后序号连续可检查；BLE 链路不得发送原始帧。

- [ ] **Step 7: 性能分析**

逐模块记录耗时、峰值堆和有效坐标率。原型目标为 20～30 个有效坐标/秒；达不到时优先缩小 ROI 和复用上一帧网格，不降低方向置信度门槛掩盖性能问题。

- [ ] **Step 8: 建议提交点**

```powershell
git add components/anoto_embedded components/pen_pose components/ble_transport pc/src/digital_pen/transport main/app_main.c
git commit -m "feat: decode Anoto pen coordinates on ESP32-S3"
```

**Exit Gate:** ESP32-S3 对真实帧独立输出稳定笔尖坐标；终端通过 BLE 只接收坐标/笔状态并完成笔画显示和字符识别，产品实时运行不依赖 Wi-Fi/USB 原始帧。

---

## 6. 阶段里程碑总表

| 里程碑 | 可演示结果 | 通过标准 |
|---|---|---|
| M0 协议 | JSON 窗口直接解码 | 1000/1000 正确 |
| M1 相机 | OV5640 连续灰度采集 | 1000 帧无重启、无持续内存下降 |
| M2 开发传输 | PC 经 Wi-Fi/USB 保存原始 PGM | STA HTTP 主通道（失败回退 SoftAP）100 帧尺寸一致、帧号递增 |
| M3 黑点视觉 | 标出网格中心和四方向 | 点检出率 ≥98%，方向正确率 ≥99% |
| M4 坐标 | 静态图输出 Anoto 坐标 | 清晰帧正确率 ≥95% |
| M5 轨迹 | PC 重绘横竖线、圆、十字 | 慢速有效位置 ≥20/s，误差 ≤1 mm |
| M6 墨迹状态 | 自动分出简单字符笔画 | 悬空不记录，起点不明显缺失，笔画不误连 |
| M7 识别闭环 | 写数字并输出候选结果 | 重建轨迹正确，识别结果可重复 |
| M8 嵌入式坐标与 BLE | ESP32 经 BLE 输出笔尖坐标 | 与 PC 同帧误差 ≤0.3 mm，20～30 点/s，终端不接收原始帧 |

---

## 7. 推荐执行顺序

严格按以下顺序执行，任何里程碑未通过时停留在当前层定位：

1. Task 1：黑白点阵和协议真值。
2. Task 2：PC 包与类型契约。
3. Task 3：OV5640 稳定出图。
4. Task 4：开发阶段通过 Wi-Fi STA + HTTP 无损传帧，连接失败自动回退 SoftAP，USB 保留诊断/可选。
5. Task 5～7：静态黑点视觉与坐标解码。
6. Task 8：实时笔尖坐标和人工笔画。
7. Task 9：新墨迹落笔/抬笔判断。
8. Task 10：PC 字符识别闭环。
9. Task 11：坐标前端移植 ESP32-S3，并通过 BLE 向终端发送坐标。

第一个必须攻克的工程里程碑不是“识别汉字”，而是：

> OV5640 拍摄一张静止黑白点阵纸，ESP32-S3 将原始灰度图交给 PC，PC 正确标出黑点质心、虚拟网格、偏移方向，并输出与 Generator 真值一致的 Anoto 坐标。

达到该里程碑后，再开始动态笔尖轨迹；达到人工落笔轨迹稳定后，再实现新墨迹落笔判断；只有轨迹肉眼正确后，才评估字符识别模型。

---

## 8. 每阶段统一验证命令

PC 端每次合并前运行：

```powershell
python -m pytest pc/tests -v
python -m ruff check pc tools/patterns
```

ESP-IDF 固件每次合并前运行：

```powershell
idf.py build
```

涉及真实硬件的阶段额外执行对应的 100 帧或 1000 帧稳定性命令，并保留日志中的帧数、超时数、有效坐标率、平均耗时和峰值内存。只有对应 Exit Gate 的测量值达到门槛，才能勾选该任务并进入下一阶段。
