Mmrliu-gooooood/digital_pen/digital_pen_ov5640/docs/pattern-parameters.md

# Anoto 黑白点阵打印参数

## 固化 Profile

| Profile | 网格间距 | 方向偏移 | 点半径 | 建议打印分辨率 | 用途 |
|---|---:|---:|---:|---:|---|
| A | 3.5278 mm | 1.0583 mm | 0.3528 mm | 600 DPI | 协议与视觉调试 |
| B | 1.0000 mm | 0.1670 mm | 0.1000 mm | 600 DPI | 光学过渡 |
| C | 0.3000 mm | 0.0500 mm | 0.0500 mm | 1200 DPI | 目标微点 |

四个方向均以纯黑 `#000000` 输出。PDF 为 A4 矢量文件，打印时必须选择“实际大小”或 100%，禁止“适合页面”。

## 每次打印记录规则

实际打印前，为生成的 manifest 补充或随实验记录保存以下信息：

- 打印机厂商与型号；
- 打印机标称 DPI；
- 纸张类型；
- 使用的 profile、section 和 page ID；
- 打印日期；
- 打印缩放必须为 100%；
- 使用卡尺或带标尺扫描图测得的实际网格间距。

Task 1 完成时尚未执行实体打印，因此没有伪造打印机与实测尺寸。首次打印属于进入相机视觉实验前的硬件记录步骤。
