Mmrliu-gooooood/digital_pen/digital_pen_ov5640/artifacts/task5/live-ov5640-binary.png

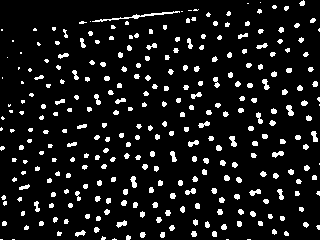
digital_pen_ov5640/artifacts/task5/live-ov5640-binary.png
