Mmrliu-gooooood/digital_pen/digital_pen_ov5640/artifacts/task5/live-stages/input.png

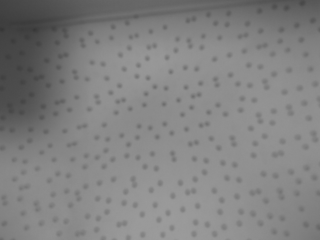
digital_pen_ov5640/artifacts/task5/live-stages/input.png
