Mmrliu-gooooood/digital_pen/digital_pen_ov5640/artifacts/task5/ov5640-adjusted-binary.png

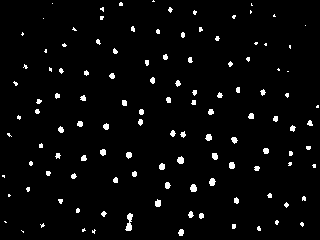
digital_pen_ov5640/artifacts/task5/ov5640-adjusted-binary.png
