Mmrliu-gooooood/digital_pen/digital_pen_ov5640/artifacts/task5/phone-morph-annotated-preview.png

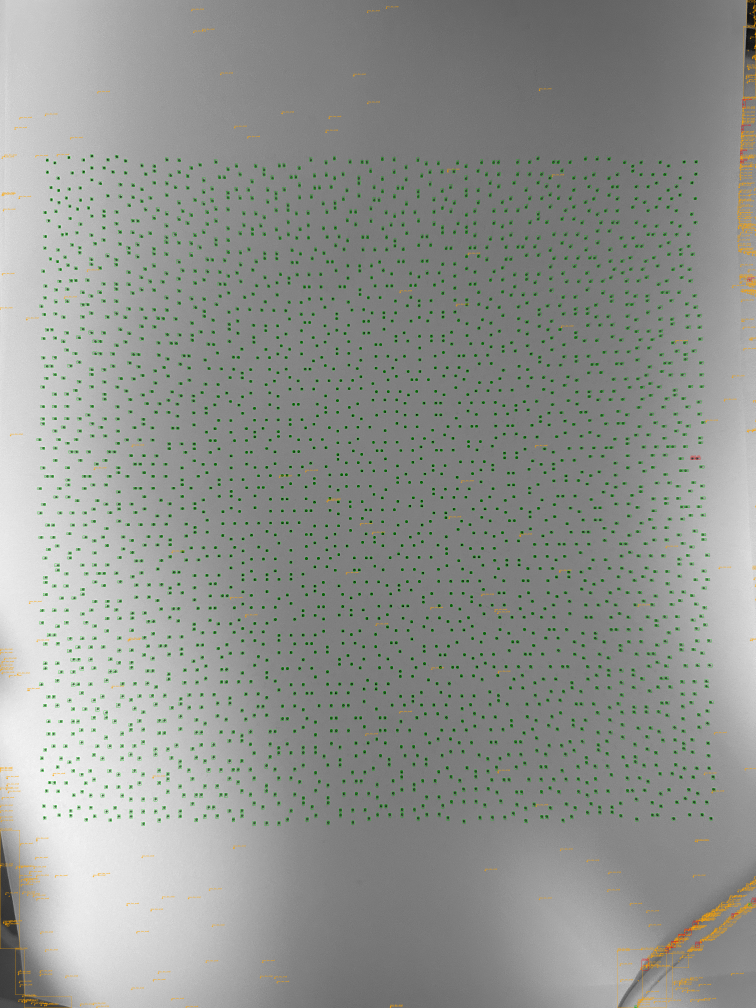
digital_pen_ov5640/artifacts/task5/phone-morph-annotated-preview.png
