Mmrliu-gooooood/digital_pen/digital_pen_ov5640/artifacts/task5/phone-morph-binary.png

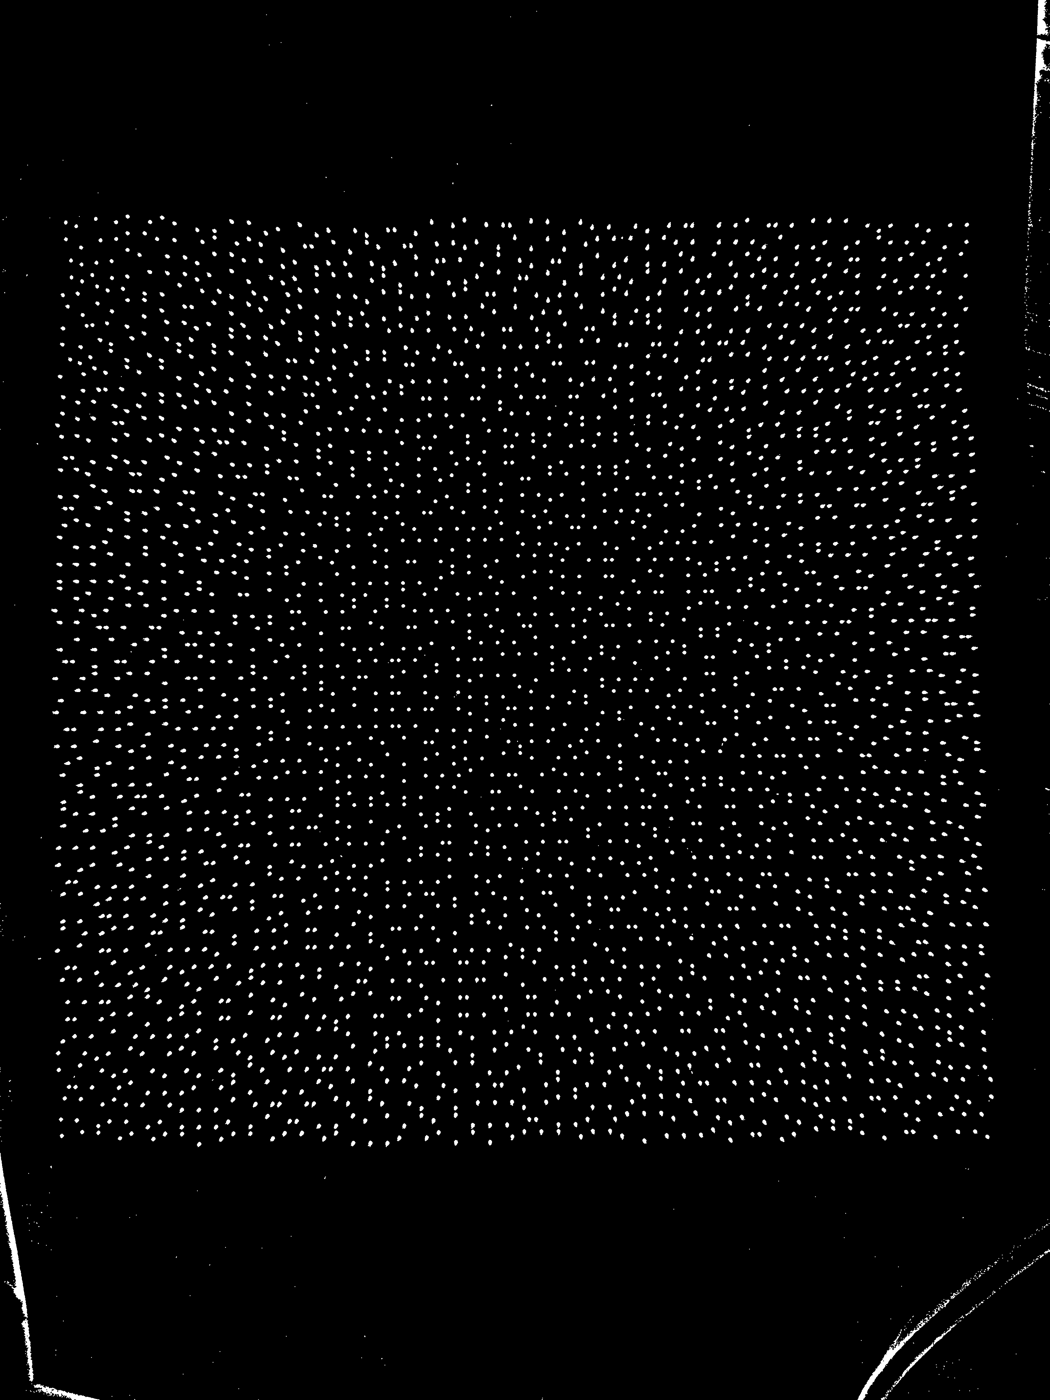
digital_pen_ov5640/artifacts/task5/phone-morph-binary.png
