Mmrliu-gooooood/digital_pen/digital_pen_ov5640/artifacts/task7/decoded-000100.png

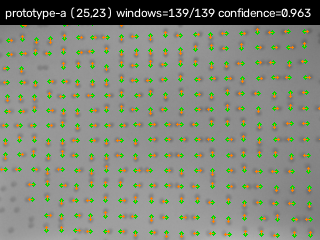
digital_pen_ov5640/artifacts/task7/decoded-000100.png
