Mmrliu-gooooood/digital_pen/dot_picture/打印纸的扫描仪扫描图png.png

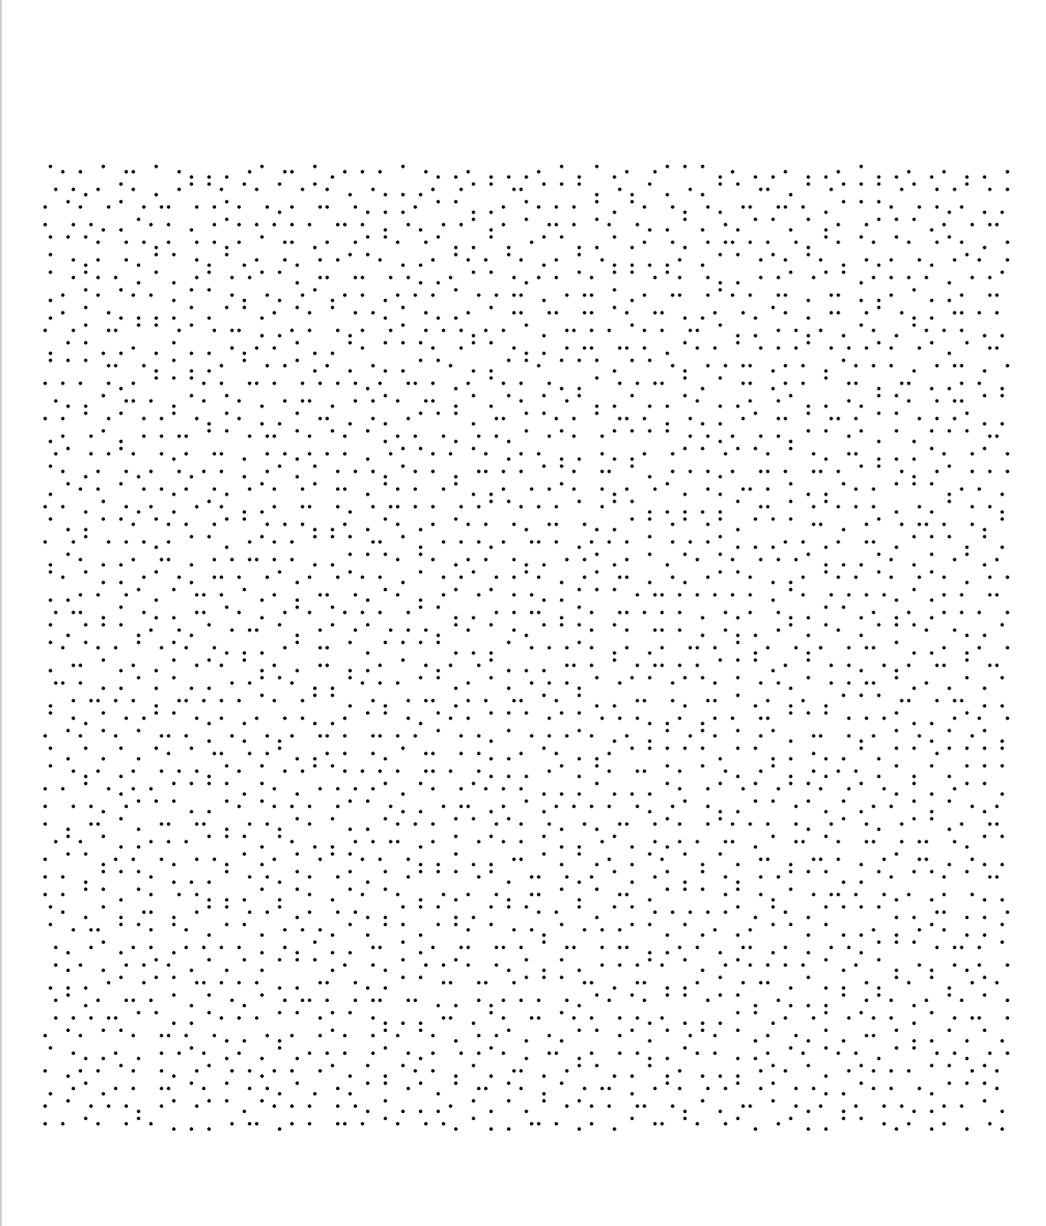
dot_picture/打印纸的扫描仪扫描图png.png
