Mmrliu-gooooood/digital_pen/OV5640_V4_高度可调_九件试装包/v4_preview_lowest_150mm.png

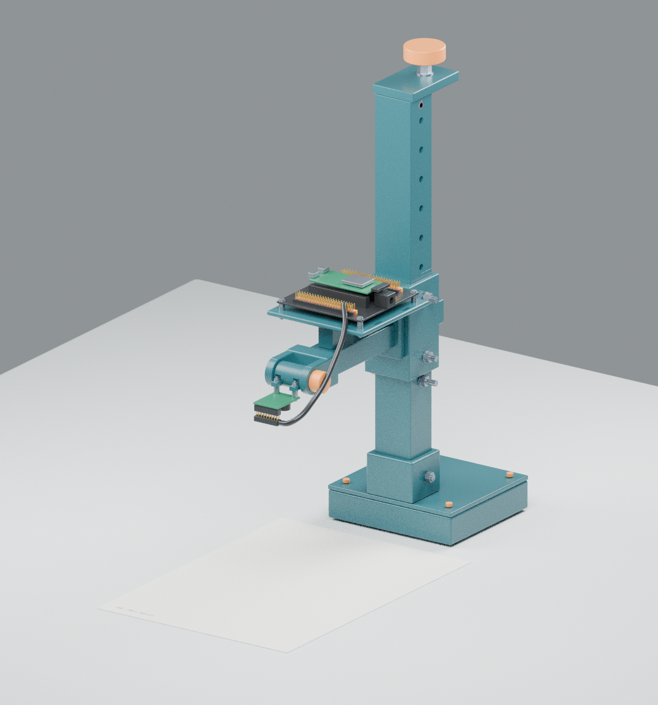
OV5640_V4_高度可调_九件试装包/v4_preview_lowest_150mm.png
