Mmrliu-gooooood/digital_pen/OV5640_V4_整体装配展示_275mm.stl

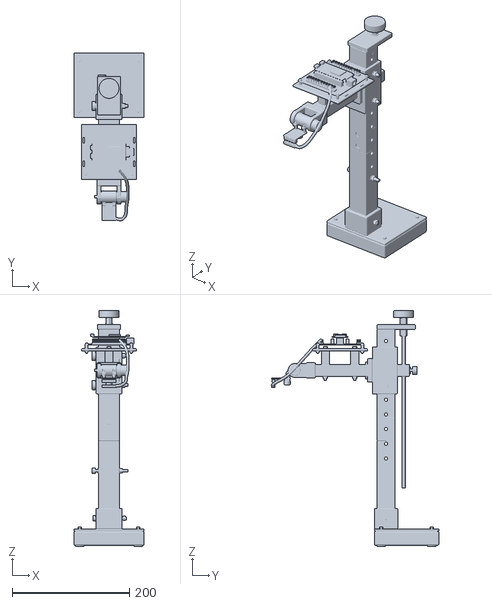
[picture p22: CAD file, 2026-10-02]
OV5640_V4_整体装配展示_275mm.stl
120.0 x 285.6 x 402.0
