Mmrliu-gooooood/digital_pen/OV5640_V4_高度可调_九件试装包/STL_mm_试装原型/V4_08_electronics_tray.stl

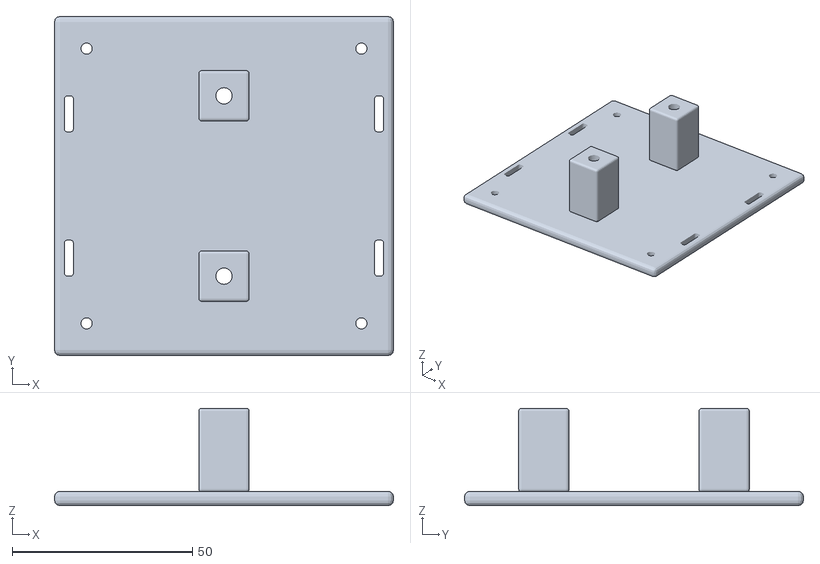
[picture p24: CAD file, 2026-10-02]
OV5640_V4_高度可调_九件试装包/STL_mm_试装原型/V4_08_electronics_tray.stl
94.0 x 94.0 x 27.0
