Mmrliu-gooooood/digital_pen/OV5640_V4_高度可调_九件试装包/STL_mm_试装原型/V4_05_indexed_80mm_carriage.stl

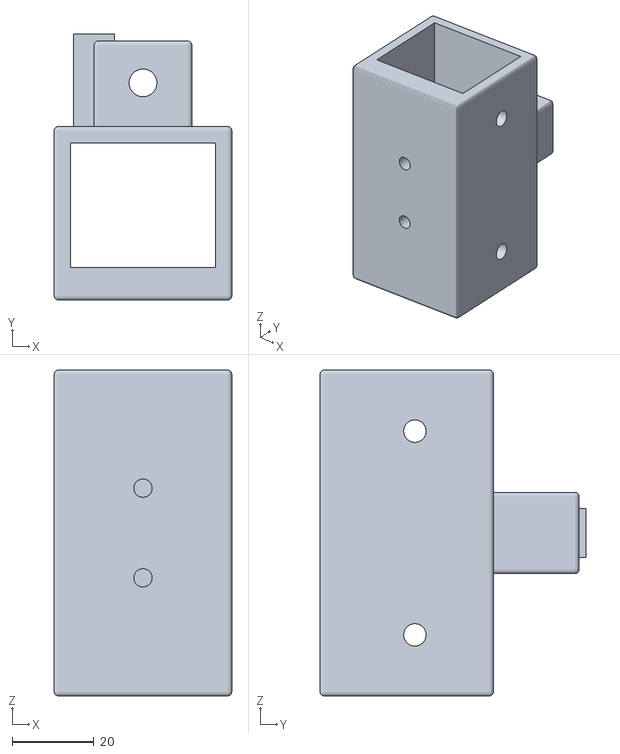
[picture p25: CAD file, 2026-10-02]
OV5640_V4_高度可调_九件试装包/STL_mm_试装原型/V4_05_indexed_80mm_carriage.stl
43.6 x 65.3 x 80.0
