Mmrliu-gooooood/digital_pen/OV5640_V4_高度可调_九件试装包/STL_mm_试装原型/V4_02_base_lid_and_socket.stl

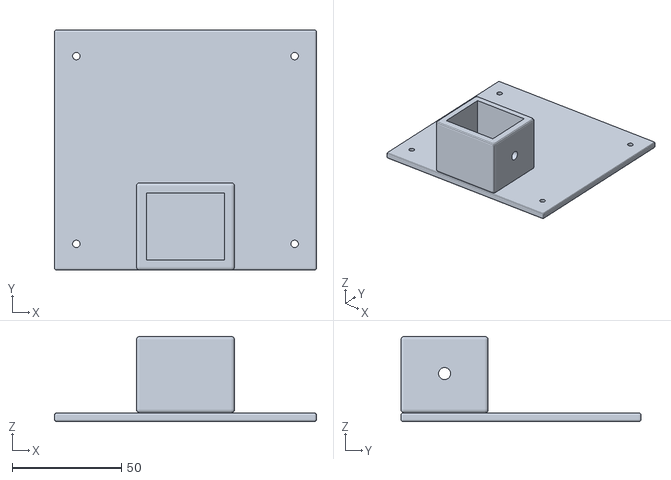
[picture p26: CAD file, 2026-10-02]
OV5640_V4_高度可调_九件试装包/STL_mm_试装原型/V4_02_base_lid_and_socket.stl
120.0 x 110.0 x 39.0
