Mmrliu-gooooood/digital_pen/OV5640_V4_高度可调_九件试装包/STL_mm_试装原型/V4_06_arm_and_fixed_pitch_fork.stl

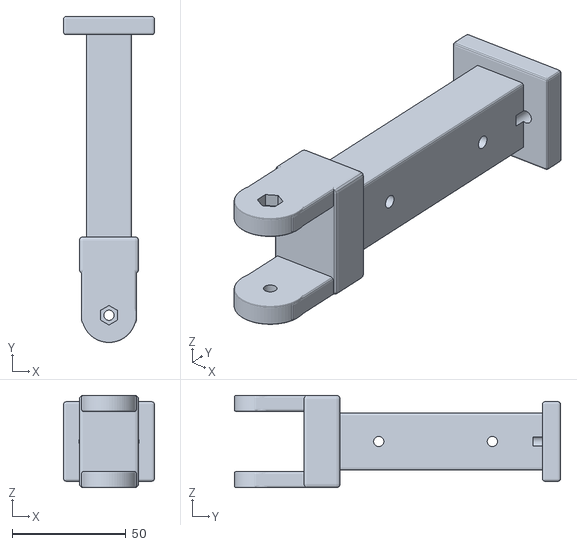
[picture p27: CAD file, 2026-10-02]
OV5640_V4_高度可调_九件试装包/STL_mm_试装原型/V4_06_arm_and_fixed_pitch_fork.stl
40.0 x 143.5 x 40.6
