Mmrliu-gooooood/digital_pen/OV5640_V4_高度可调_九件试装包/STL_mm_试装原型/V4_07_pitch_carrier.stl

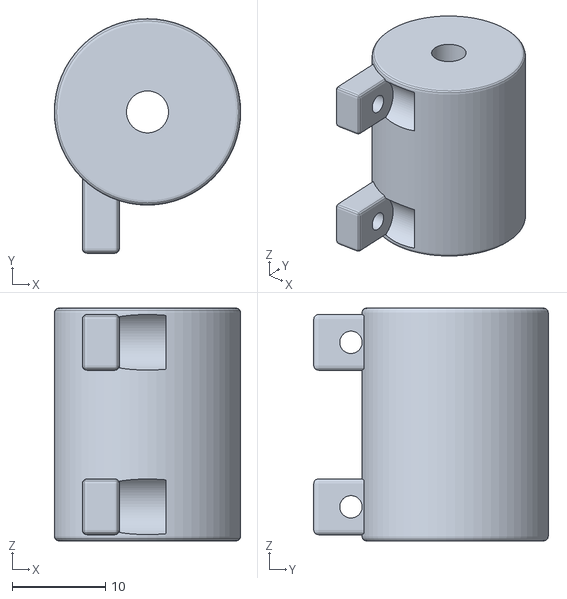
[picture p28: CAD file, 2026-10-02]
OV5640_V4_高度可调_九件试装包/STL_mm_试装原型/V4_07_pitch_carrier.stl
20.0 x 25.2 x 25.0
