Mmrliu-gooooood/digital_pen/OV5640_V4_高度可调_九件试装包/STL_mm_试装原型/V4_03_lower_guide_mast190.stl

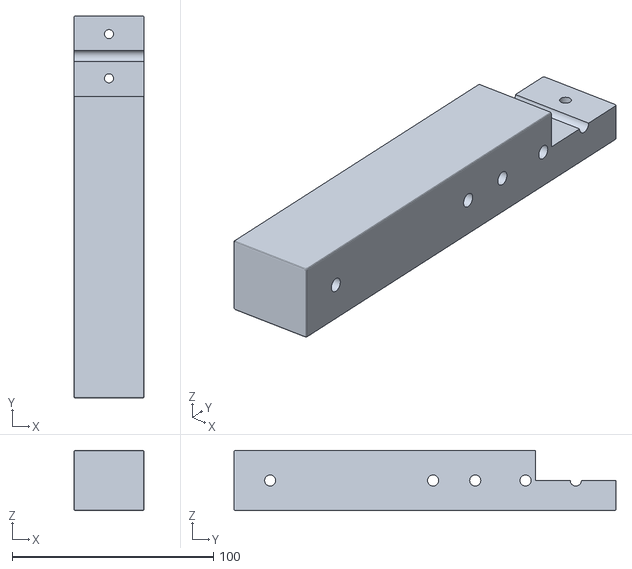
[picture p29: CAD file, 2026-10-02]
OV5640_V4_高度可调_九件试装包/STL_mm_试装原型/V4_03_lower_guide_mast190.stl
35.0 x 190.0 x 30.0
