Mmrliu-gooooood/digital_pen/OV5640_V4_高度可调_九件试装包/STL_mm_试装原型/V4_09_lead_screw_top_cap.stl

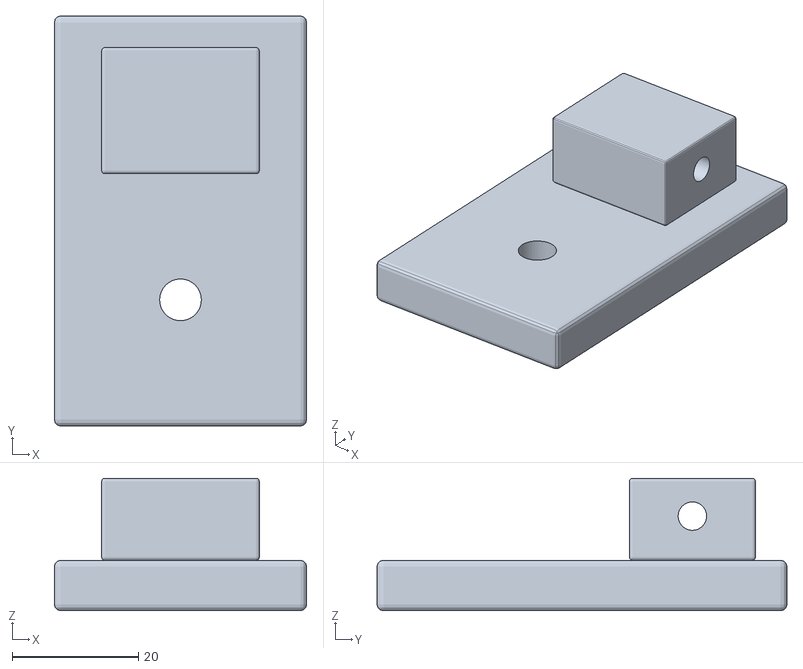
[picture p31: CAD file, 2026-10-02]
OV5640_V4_高度可调_九件试装包/STL_mm_试装原型/V4_09_lead_screw_top_cap.stl
40.0 x 65.0 x 21.0
