Mmrliu-gooooood/digital_pen/(list of files, cad)

Other CAD files:
OV5640_V4_高度可调_九件试装包/OV5640_height_adjustable_v4.blend
