Mmrliu-gooooood/digital_pen/digital_pen_ov5640/artifacts/task5/printer-scan-annotated.png

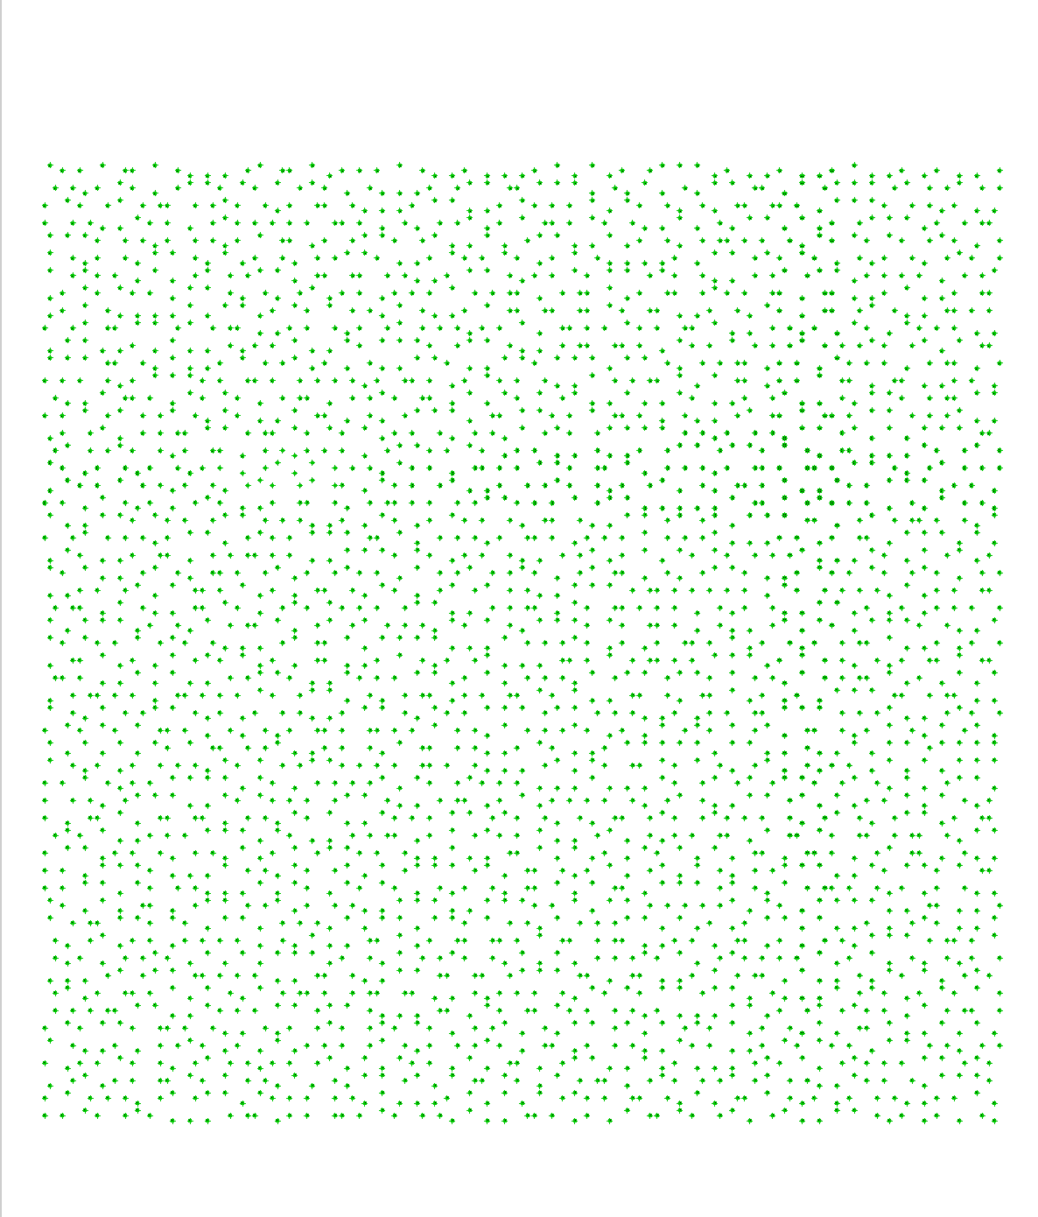
digital_pen_ov5640/artifacts/task5/printer-scan-annotated.png
