Mmrliu-gooooood/digital_pen/OV5640_V4_高度可调_九件试装包/README_V4升降调试支架.txt

OV5640 + ESP32-S3｜V4 升降调试支架｜试装设计

一、改动与范围
保留V3后置配重底座、单柱、小俯仰头和集成电子托盘。改为固定高导轨 + 方形滑套升降，相机和扩展板一起移动；低位时立柱本身不缩短。
- 镜头离纸名义档位：150 / 175 / 200 / 225 / 250 / 275 / 300mm
- 默认275mm。镜头突出量仍是示意值，装实物后应重新标定高度
- 每档25mm；滑套全程保持80mm导向长度；方形截面限制转动
- 两颗M5贯穿锁定螺栓相距50mm，用于承重和定位，不靠消隙旋钮摩擦吊住组件
- 后方金属M6丝杆和金属螺母在调节时承托组件；另有M4尼龙头顶丝轻压消隙
- 标准设计牙距为1mm，因此25mm一档约需转动25圈，适合慢速调试
- 顶盖与下限位螺栓限制过度行程；禁止强拧到止挡

二、尺寸、文件与Blender操作
- 底座占地120×110mm；整体含悬臂约120×286×402mm
- 固定立柱顶370mm，手轮顶约402mm
- 9个独立打印件；最长STL轴向尺寸190mm，全部为毫米坐标
- 打印姿态及每件包络见CSV；滑动面、孔和沉孔必须试配，不能假设打印后直接合适
- 原生文件默认显示275mm。选择“CONTROLS • adjust custom properties”，在自定义属性中将Height_index改成整数0–6；依次对应上述七档
- Pitch_deg控制相机俯仰，仍建议先在±20°内试配
- 高度使用Blender普通简单表达式驱动，不需要嵌入启动脚本；M6丝杆转动没有动画同步
- 低位适合小区域测试；不宣称150mm能覆盖整张16K纸

三、每次调节顺序
1. 扶稳底座，用手托住上部组件；确认M6螺母已完整嵌入滑套，丝杆正确啮合、上下轴向锁母和手轮已固定
2. 稍松后侧消隙顶丝，让滑套可运动；取出两颗M5锁定螺栓前仍要托住组件
3. 检查丝杆确实承托，再缓慢转手轮，另一只手稳住底座或组件；不要把手指放在滑套下方夹缝
4. 对准目标档位后装回两颗M5贯穿螺栓、垫片和螺母并拧紧；不得只装一颗
5. 轻调消隙顶丝，使组件无明显晃动，不要把塑料导轨压陷；检查俯仰、线束余量，再开始拍摄
禁止在锁定螺栓仍插着时强转手轮。未验证丝杆自锁，不能把它当成绝对防坠机构；调节时仍应扶住组件。

四、主要五金
所有长度均为当前叠厚的试装建议，实际头型、垫片和公差须核对。
- M3×30螺丝4颗、M3螺母4颗：底盖
- M5×55螺丝/手拧螺栓共4颗及配套螺母：底部立柱座1、滑套锁定2、下限位1
- M4×25内六角圆柱头2颗、M4螺母2颗：立柱半搭接；头部和螺母必须完全沉入导向外轮廓
- M4×30内六角圆柱头1颗、M4螺母1颗：顶盖内插键，同样须齐平
- M4×16内六角圆柱头2颗、M4螺母2颗：悬臂到滑套前壁；不得换成长螺丝顶住立柱
- M4×30尼龙头消隙顶丝1颗、M4螺母1颗
- M6×300金属螺纹杆1根，牙距1mm；M6螺母5颗，M6承压平垫2片
  其中1颗M6螺母嵌入滑套；顶盖上下各用2颗对锁，固定杆的轴向位置
- 6mm轴孔、带紧定螺钉的手轮1只；手轮须夹紧在杆上，不能使用会自行旋出的松动内螺纹旋钮
- M4×45俯仰手拧螺杆1颗、M4螺母1颗、两片约0.8mm摩擦垫
- M4×55托盘螺丝2颗、M4螺母2颗
- 相机：M2×16螺丝2颗、螺母2颗、平垫4片、暂定6.2mm隔柱2个
- 扩展板：M2.5×16螺丝4颗、螺母4颗、平垫8片、6mm隔柱4个
- 相应平垫、防滑脚垫和固定配重的软垫

五、首次装配要点
先装底座和固定立柱，检查半搭接接缝、沉头及螺母不高出滑动面。顶盖尚未安装时，从上端套入滑套，在低档先用两颗M5螺栓固定，再装悬臂/托盘。
先把M6螺母从滑套后槽插入，再安装消隙顶丝和旋钮，保持后侧装配通道。丝杆组件先装顶盖下方两只M6螺母及垫圈，再穿过顶盖并装上方垫圈/锁母。将杆下端旋入滑套螺母，最后落座顶盖内插键并安装齐平横向螺丝。
上下锁母应调到没有明显轴向窜动、同时丝杆能轻松转动，再分别对锁；不要夹死塑料顶盖。需要拆顶盖时先把滑套降低，露出顶盖横销。
如果滑套卡住，不要用丝杆硬拉。修整导向面或调整打印间隙后重试。装电子件前先用假负载完成全行程和连接测试。

六、最高档的稳定性边界
建议使用约1.0kg固定牢的密实金属配重。本版示例100×74×17.2mm钢块，按钢密度估算约0.999kg；配2mm下软垫、0.8mm上软垫，能放进当前底腔并避开螺丝柱。实际应称重、核对堆叠高度，不能让钢块在盒内晃动。
保守示例：若移动上部质量0.30kg，重心在底座前支撑边前方70mm，前倾力矩约0.21N·m；1.0kg配重在后方55mm力臂提供约0.54N·m。此计算没有把打印件按实心塑料虚构称重。
这个余量不代表抗碰撞稳定。在上述假设下，300mm高处额外约1.1N的水平拉力就可能消耗余量；从更高的手轮处拉动更不利。线缆应固定并留松弛，调整时扶稳底座。若实际测试会晃动或倾倒，就需要更大底座/配重或进一步结构修改，不能因为数字模型通过而直接使用。
USB/电源线必须做应力缓解：先在移动托盘的走线槽固定线缆，沿立柱外侧留足至少150mm的升降余量，再把通往电脑的线固定在底座后侧，底座外仍留松弛。线环不得进入滑套、丝杆或锁销，也不能把扎带绑在滑套会经过的导向面上。不要让悬空USB线的外部拉力直接作用到上端。这个布线固定点需要按实物验证，不是模型已经认证好的保护。
实体刚度、连接间隙、最高位挠度、蠕变、抗倾倒与丝杆承托能力均未测试。最高位置尤其要用假负载检查，不能宣称对任意外力都稳固。

七、光学与交付性质
镜头和连接器仍是未实测包络。275mm覆盖16K是理想估计；约0.706mm点径在真正输出2592×1944时理想约6像素/点，降低输出分辨率或缩小纸张会改变结果。每个测试高度都需要重新检查对焦、覆盖范围、畸变与点阵识别。
本包是可编辑、可试装设计，数字网格/干涉检查不等于实体打印适配、机械强度、防坠或视觉识别认证。未修改用户的原始点阵PDF。
