Mmrliu-gooooood/digital_pen/dot_picture/prototype-a_55x55_s10_2.pdf

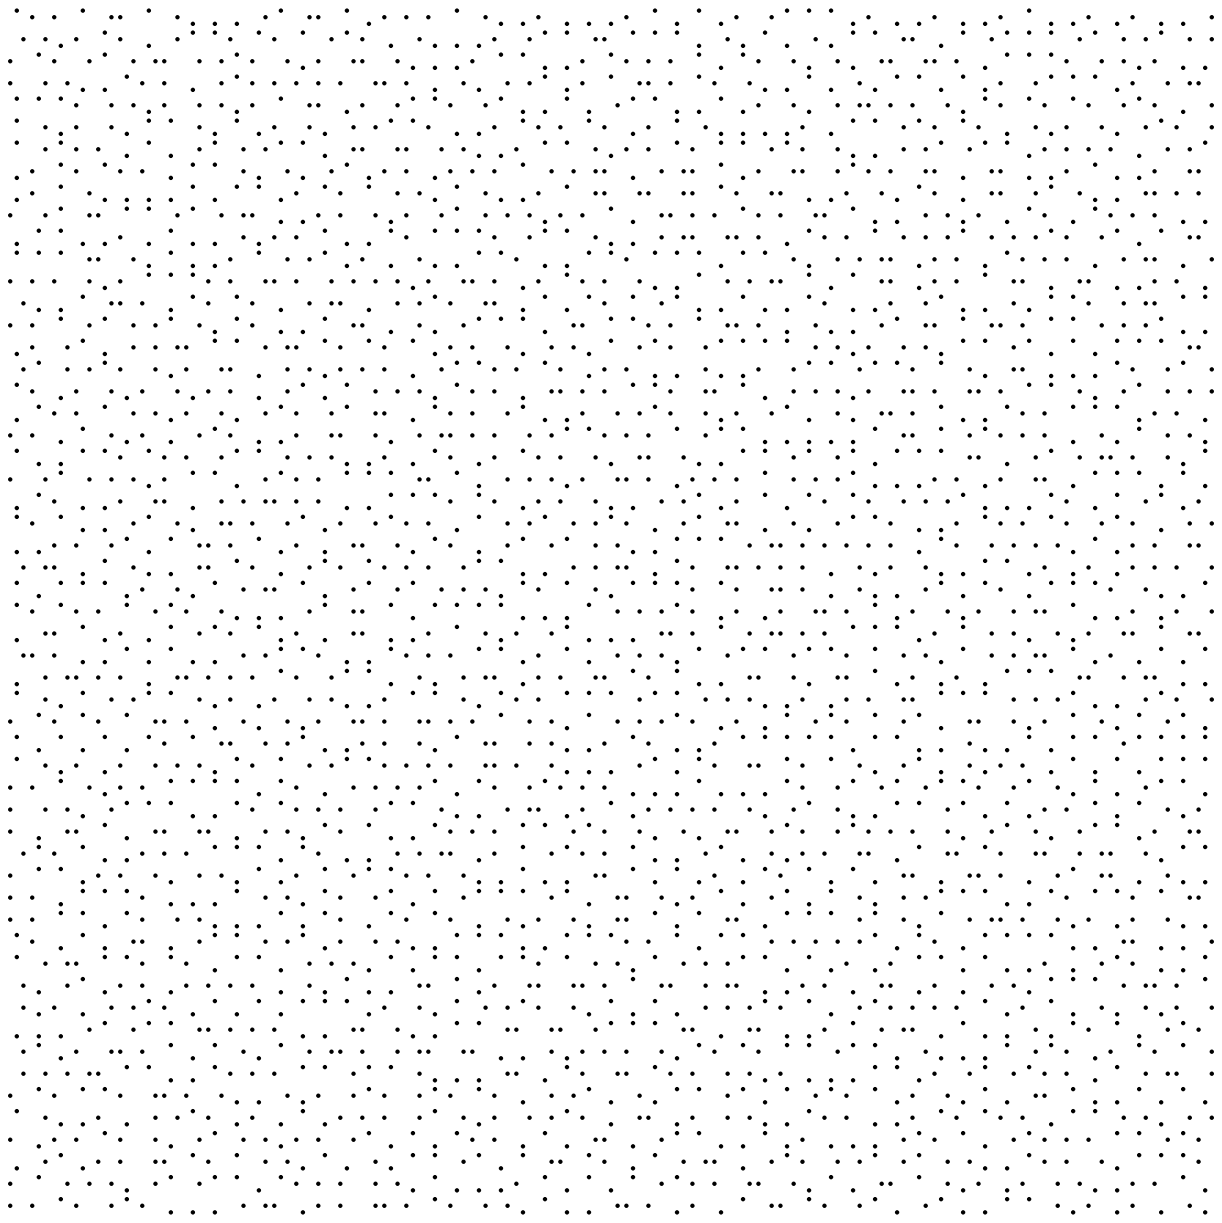
[picture p34: page 1]
