Mmrliu-gooooood/digital_pen/点阵笔资料/SC035HGS_DVP_24Minput_72MPCLK_640x480_60FPS.ini

//Preview Type:0:DVP Raw 10 bit// 1:Raw 8 bit// 2:YUV422// 3:RAW16
//Preview Type:4:RGB565// 5:Pixart SPI// 6:MIPI 10bit// 7:MIPI 12bit// 8: MTK SPI
//port  0:MIPI// 1:Parallel// 2:MTK// 3:SPI// 4:TEST// 5: HISPI// 6 : Z2P/Z4P
//I2C Mode    :0:Normal 8Addr,8Data//  1:Samsung 8 Addr,8Data// 2:Micron 8 Addr,16Data
//I2C Mode    :3:Stmicro 16Addr,8Data//4:Micron2 16 Addr,16Data
//Out Format  :0:YCbYCr/RG_GB// 1:YCrYCb/GR_BG// 2:CbYCrY/GB_RG// 3:CrYCbY/BG_GR
//MCLK Speed  :0:6M//1:8M//2:10M//3:11.4M//4:12M//5:12.5M//6:13.5M//7:15M//8:18M//9:24M
//pin  :BIT0 pwdn// BIT1:reset
//avdd  0:2.8V// 1:2.5V// 2:1.8V
//dovdd  0:2.8V// 1:2.5V// 2:1.8V
//dvdd  0:1.8V// 1:1.5V// 2:1.2V


[DataBase]
DBName=Dothinkey

[Vendor]
VendorName=SmartSens

[Sensor]                  
SensorName=SC031GS
width=640
height=480
port=1
type=1
pin=2
SlaveID=0x60
mode=3
FlagReg=0x36FF
FlagMask=0xff
FlagData=0x00
FlagReg1=0x36FF
FlagMask1=0xff
FlagData1=0x00
outformat=3
mclk=24
fps=60.0
avdd=2.800000
dovdd=1.800000
dvdd=1.500000

Ext0=0
Ext1=0
Ext2=0
AFVCC=2.513000
VPP=0.000000

[ParaList]
0x0100,0x00,
0x300f,0x0f,
0x3018,0x1f,
0x3019,0xff,
0x301c,0xb4,
0x3028,0x82,
0x320c,0x03,
0x320d,0x6e,
0x320e,0x05,
0x320f,0x56,
0x3220,0x10,
0x3250,0xf0,
0x3251,0x02,
0x3252,0x05,
0x3253,0x51,
0x3254,0x02,
0x3255,0x07,
0x3304,0x48,
0x3306,0x38,
0x3309,0x68,
0x330b,0xe0,
0x330c,0x18,
0x330f,0x20,
0x3310,0x10,
0x3314,0x42,
0x3315,0x38,
0x3316,0x48,
0x3317,0x20,
0x3329,0x3c,
0x332d,0x3c,
0x332f,0x40,
0x3335,0x44,
0x3344,0x44,
0x335b,0x80,
0x335f,0x80,
0x3366,0x06,
0x3385,0x31,
0x3387,0x51,
0x3389,0x01,
0x33b1,0x03,
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



[gain<2]
0x3314,0x42,
0x3317,0x20,
[gain>=2]
0x3314,0x4f,
0x3317,0x0f,
